BobGlicksman/Garage_Door_Controller/(commit log)

2020-07-14 added 2 photos
    I built the Wireless I/O Board expressly for this project and included photos of the final parts, wired up and working (albeit not mounted)
2020-07-18 Assembly Photos
    Assembled the unit and posted the photos here.
2020-07-18 Updated firmware
    Added comands to use internal or external wifi antenna on Photon.
2020-07-29 version 2
    Changed from polling the ultrasonic sensor every one second to a cloud function call to take a measurement. Reduces wear on the ultrasonic sensor.
